KamiOrz/flightdesk/enclosure/soft-box-v6/README.md

# FlightDesk 方盒圆弧版 V6

以原横向方盒为基础，前壳 76×40 mm、厚 18.2 mm，平面转角 R7；正面外周增加 R1.8 连续过渡，背盖边缘 R1，底座上沿 R2.4。保持 65° 屏幕倾角，石墨灰主体与青绿色按键。预览为实际 CAD 几何的关屏示意，非实物照片。

后支撑新增两侧竖棱 R5、顶部后沿 R3、与底板交接 R2 的连续圆角。清除了 V5 底座上方残留的薄台阶。安装孔、倾斜配合面及配重槽保持原位置。只需重打 `weighted-base.stl` 即可替换 V5 底座。

## 文件

- `stl/`：毫米单位，已摆到 Z=0。前壳正面朝下、背盖外侧朝下；底座平放。圆弧正面接触面较小，可加 brim，避免过度象脚。
- `flightdesk-soft-box-v6.step`：8 个制造零件，不含电子板、屏幕及金属配重。
- `model.py`：CadQuery 建模源码，依赖项目原 V1 STEP 保留经过检查的板卡安装位置。
- `checks.json`、`mesh-checks.json`：实体及网格检查记录。

## 打印与装配

建议 0.4 mm 喷嘴、0.16–0.20 mm 层高、至少 3 圈墙。底座配重槽顶和定位柱需要支撑；依据切片检查启用局部支撑。壳体、按键小件也需检查切片悬空区域。先打印 `pin-fit-coupon.stl`，检查排针和打印公差，再打印整壳。

保留两排背向直排针：PCB 背面至针尖 8.25 mm，托架承托排针塑料座，不把金属针尖硬压在槽底。塑料座承托处使用约 0.3–0.5 mm 软垫微调，禁止挤压屏幕玻璃。板卡位置基于 LILYGO 官方 T-Display S3 STEP。

先从内部装入两个按键，再装止挡片（各一颗 M2×3 自攻螺钉）；放入主板，装背面托架并用四颗 M2×8 自攻螺钉固定。背盖从内侧用两颗 M3×8 螺钉固定底座，使用薄头，确认螺钉头不碰板件。

配重块 34×20×4.85 mm、中心孔 Ø6.2 mm，从底部放入 34.6×20.6 mm 槽。Ø5.8 mm 塑料柱定位；Ø12 mm 打印压片搭住配重，用一颗 M3×6 盘头自攻螺钉固定于塑料柱 Ø2.5 mm 导孔。螺钉头高不超过 2 mm，勿用尖端过长的替代件。金属 Ø6.2 mm 孔本身不参与攻丝。底部贴防滑胶条。

已通过零件互相干涉检查（含配重）、实体有效性检查及封闭 STL 网格检查。仓库实物照片展示了一次打印装配；螺钉、软垫与打印公差应以试装确认，不要强拧。
