KamiOrz/flightdesk/THIRD_PARTY.md

# Third-party notices

The MIT license applies to this project's original code, documentation and enclosure design. It does not relicense third-party components, aircraft liveries, trademarks or flight data.

- Arduino-ESP32 / ESP-IDF: licenses supplied by Espressif and their dependencies.
- TFT_eSPI: FreeBSD license, see its upstream distribution.
- ArduinoJson: MIT license.
- DejaVu Sans: bundled font and copyright notice at `assets/fonts/LICENSE_DEJAVU`; the generated clock glyphs are derived from this font. No Apple DIN Condensed font or its raster glyphs are included.
- Node dependencies: crypto-js, protobufjs and socket.io-client retain their upstream licenses. `npm ci` installs their license files.
- Aircraft type/operator labels are short factual identifiers. PlaneSlate content 1.0.32 supplied the original personal-build catalog, but no catalog bitmap images, generated RLE streams or AI edits derived from those images are distributed here. Optional import does not grant redistribution permission. See https://github.com/PlaneSlate/liveries and its notices before using assets.
- Product photographs show an assembled personal device with separately imported artwork. Their inclusion does not grant rights to third-party artwork, airline logos or paint designs visible on screen.
- Enclosure mounting dimensions were checked against LILYGO's T-Display-S3 mechanical reference. This repository distributes the designed case parts, not the vendor's board CAD files. Hardware documentation: https://github.com/Xinyuan-LilyGO/T-Display-S3.
- Flight positions and routes belong to their respective providers. The unofficial VariFlight adapter code is not an authorization to use, redistribute or commercially exploit provider data. Its web-client protocol constants are not user credentials; no private session tokens are bundled.
- Public airframe identity supplement: https://www.flightradar24.com/data/aircraft/B-4080 and https://api.adsbdb.com/v0/aircraft/B-4080. The internal CN_AF artwork key is not an asserted ICAO operator code.

External resources are subject to their respective terms and availability. No affiliation or endorsement is claimed.
