KamiOrz/flightdesk/enclosure/soft-box-v6/v6-preview.png

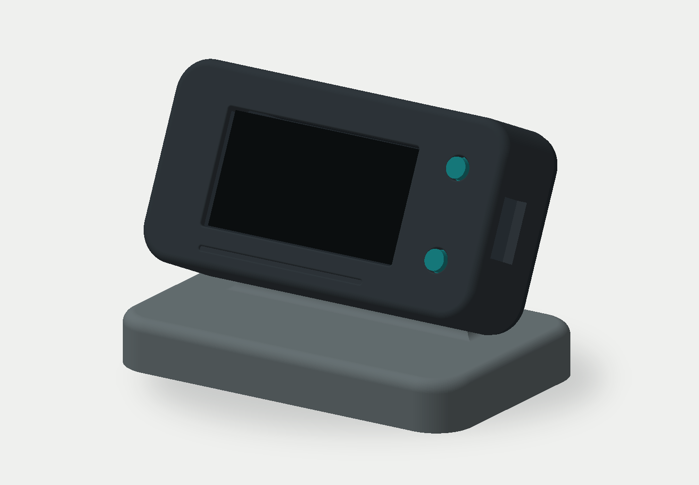
enclosure/soft-box-v6/v6-preview.png
