KamiOrz/flightdesk/enclosure/soft-box-v6/v6-rear.png

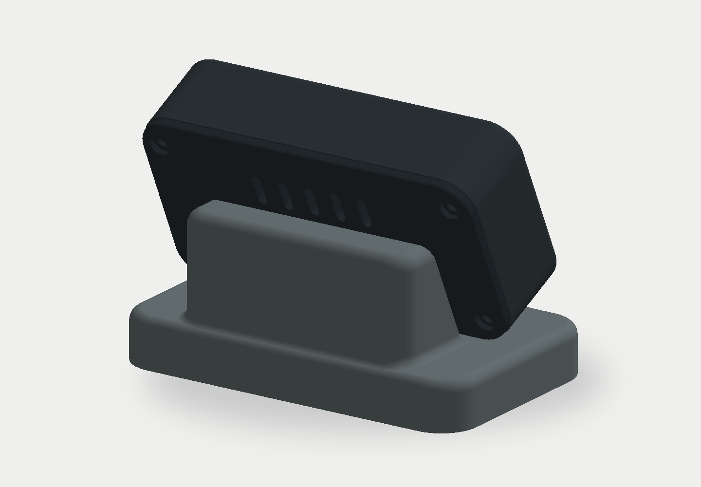
enclosure/soft-box-v6/v6-rear.png
