KamiOrz/flightdesk/enclosure/soft-box-v6/v6-side.png

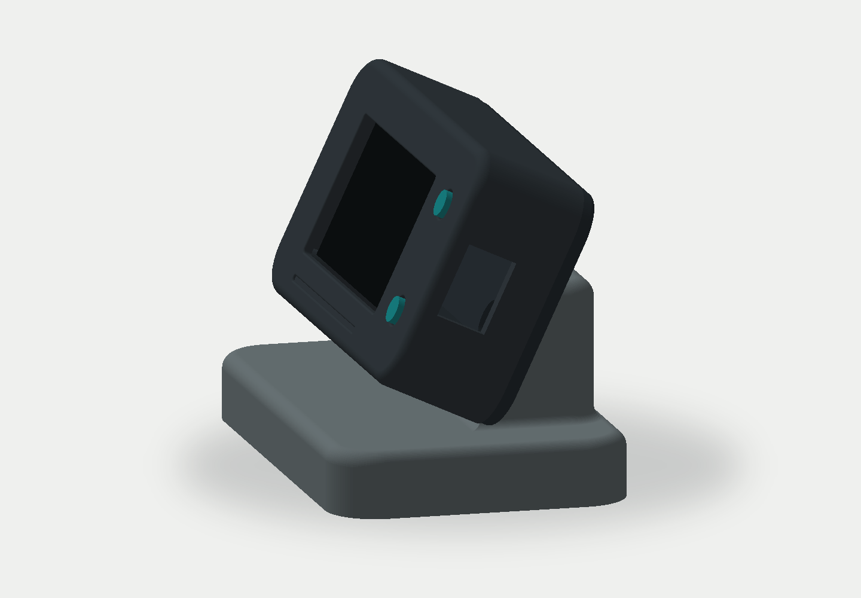
enclosure/soft-box-v6/v6-side.png
