KamiOrz/flightdesk/enclosure/flightdesk-assembly.step

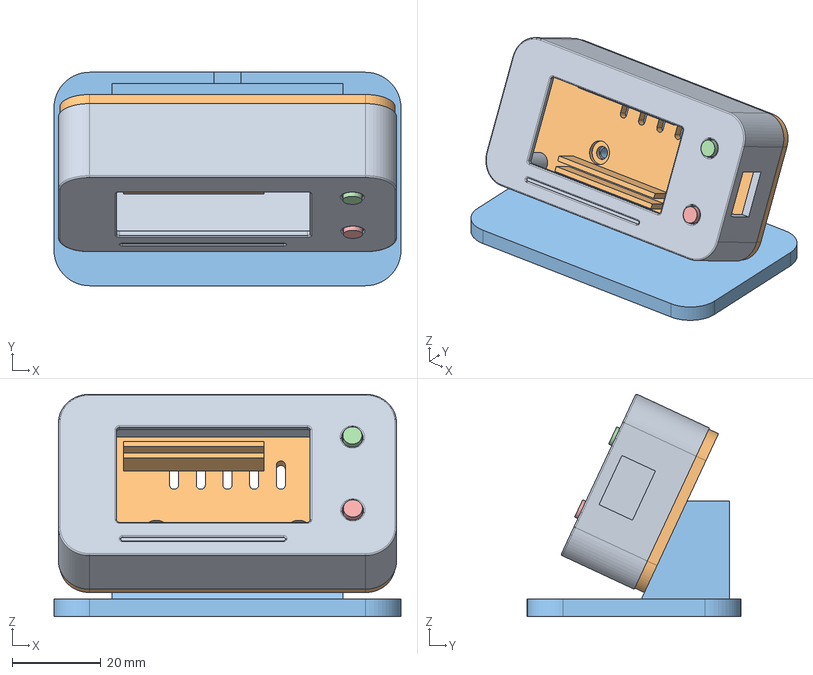
[picture p6: CAD file, 2026-11-07]
enclosure/flightdesk-assembly.step
78.0 x 48.0 x 50.0 mm
