KamiOrz/flightdesk/enclosure/soft-box-v6/flightdesk-soft-box-v6.step

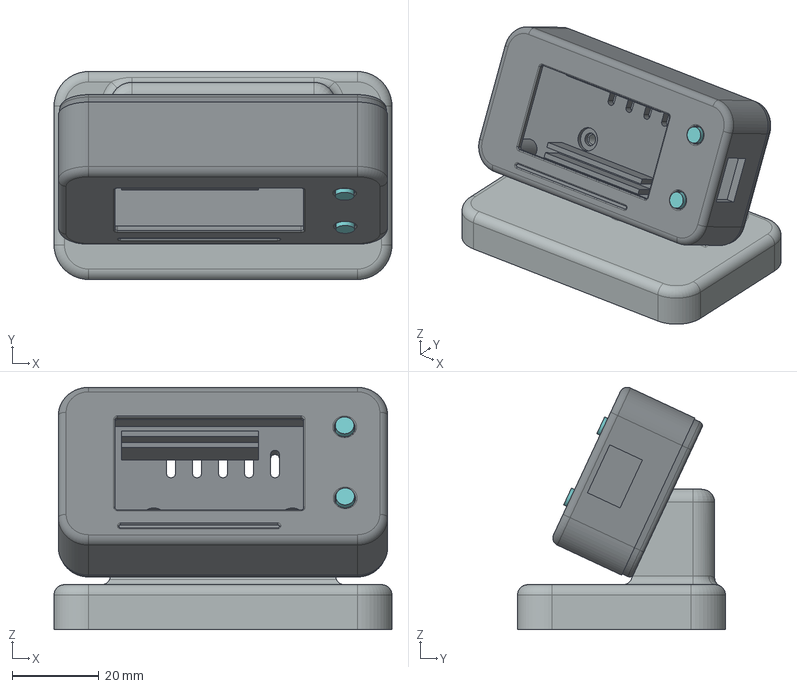
[picture p7: CAD file, 2026-11-07]
enclosure/soft-box-v6/flightdesk-soft-box-v6.step
78.0 x 48.0 x 55.9 mm
front-housing
rear-pin-carrier
weighted-base
weight-retainer
button-1
button-2
button-keeper-1
button-keeper-2
