KamiOrz/flightdesk/enclosure/soft-box-v6/stl/front-housing.stl

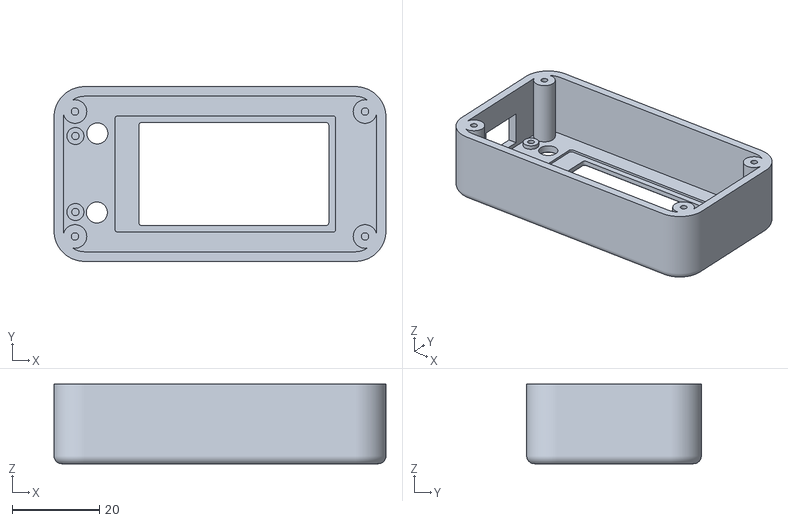
[picture p8: CAD file, 2026-11-07]
enclosure/soft-box-v6/stl/front-housing.stl
76.0 x 40.0 x 18.2
