KamiOrz/flightdesk/enclosure/soft-box-v6/stl/pin-fit-coupon.stl

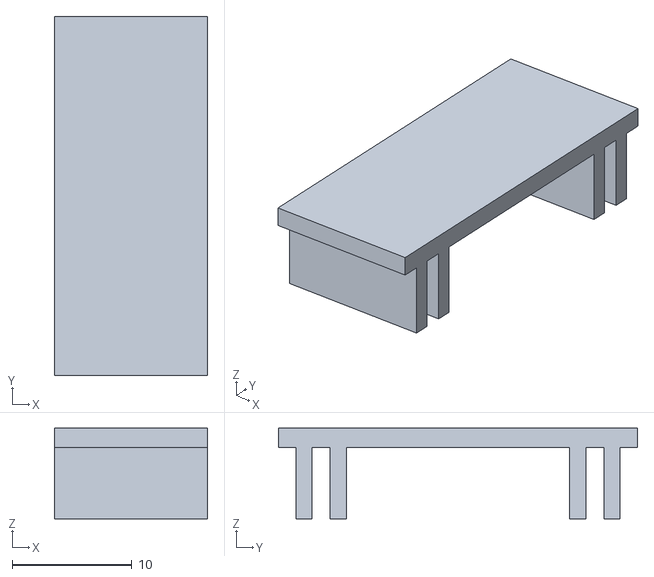
[picture p9: CAD file, 2026-11-07]
enclosure/soft-box-v6/stl/pin-fit-coupon.stl
12.8 x 30.0 x 7.58
