KamiOrz/flightdesk/enclosure/soft-box-v6/stl/button-keeper-1.stl

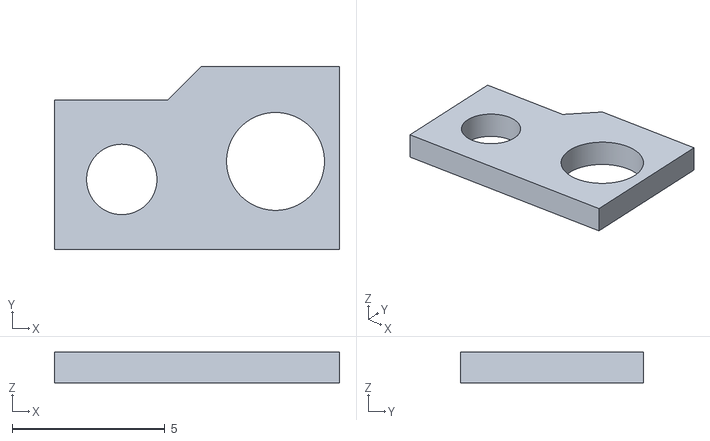
[picture p10: CAD file, 2026-11-07]
enclosure/soft-box-v6/stl/button-keeper-1.stl
9.32 x 6.00 x 1
