KamiOrz/flightdesk/enclosure/soft-box-v6/stl/rear-pin-carrier.stl

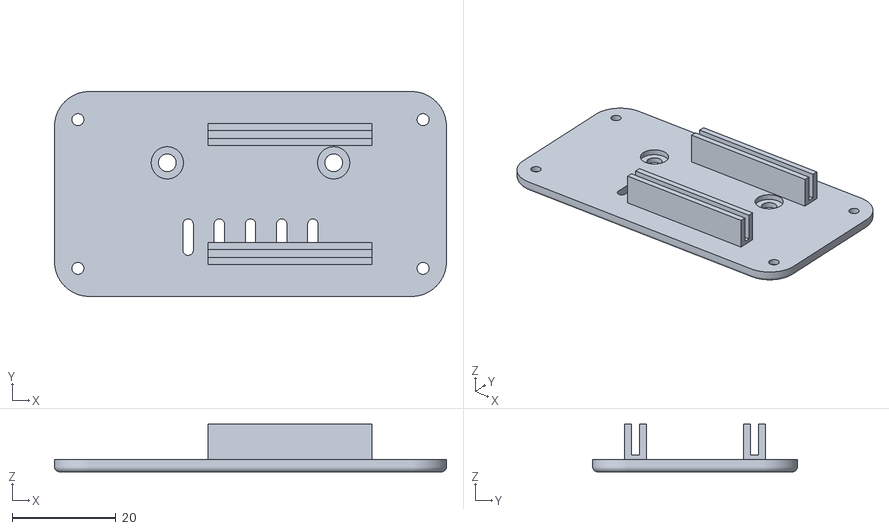
[picture p11: CAD file, 2026-11-07]
enclosure/soft-box-v6/stl/rear-pin-carrier.stl
75.4 x 39.4 x 9.18
