KamiOrz/flightdesk/enclosure/soft-box-v6/stl/weight-retainer.stl

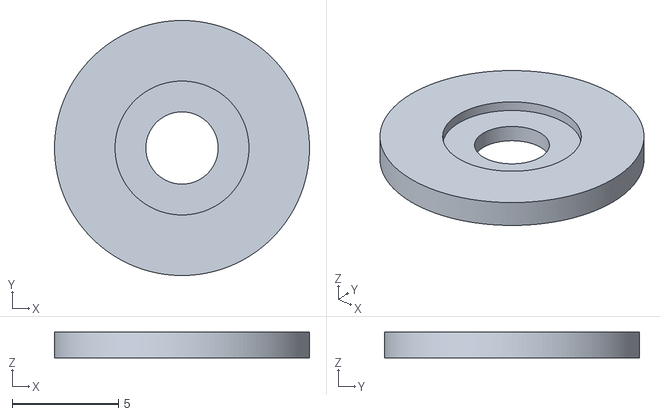
[picture p12: CAD file, 2026-11-07]
enclosure/soft-box-v6/stl/weight-retainer.stl
12.0 x 12.0 x 1.20
