KamiOrz/flightdesk/enclosure/soft-box-v6/stl/button-2.stl

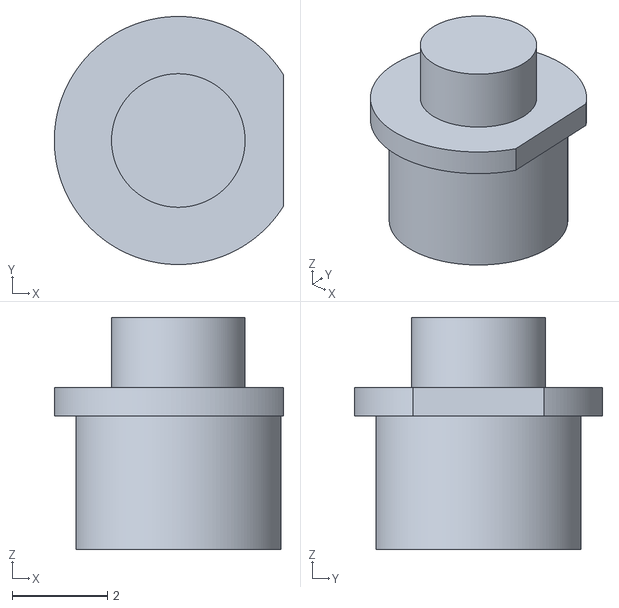
[picture p13: CAD file, 2026-11-07]
enclosure/soft-box-v6/stl/button-2.stl
4.81 x 5.20 x 4.87
