KamiOrz/flightdesk/enclosure/soft-box-v6/stl/weighted-base.stl

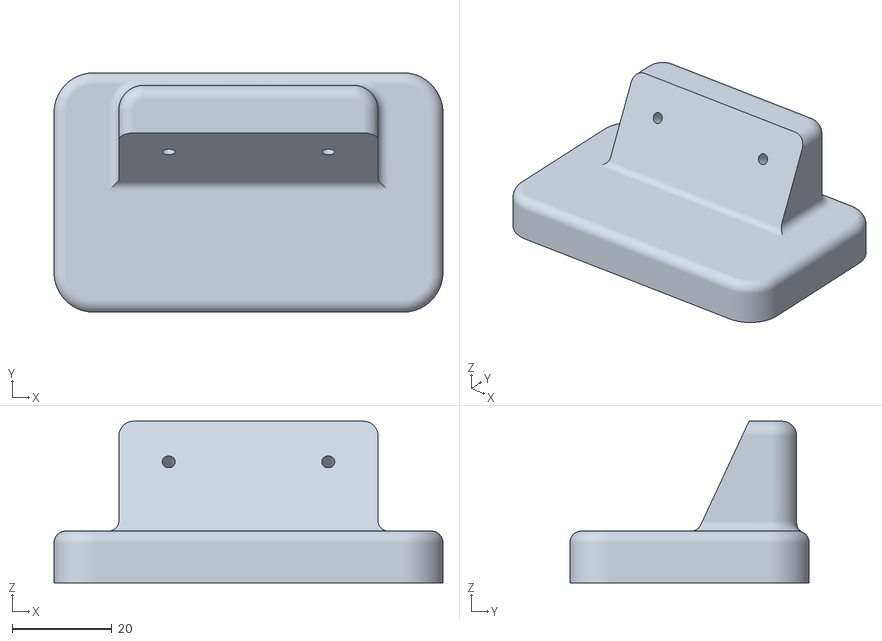
[picture p14: CAD file, 2026-11-07]
enclosure/soft-box-v6/stl/weighted-base.stl
78.0 x 48.0 x 32.4
