KamiOrz/flightdesk/(list of files, cad)

Other CAD files:
enclosure/soft-box-v6/stl/button-keeper-2.stl
enclosure/soft-box-v6/stl/button-1.stl
