KamiOrz/flightdesk/include/clock_font.h

#pragma once
#include <Arduino.h>
// DejaVu Sans digit rasterization; see assets/fonts/LICENSE_DEJAVU.
constexpr int CLOCK_GLYPH_W=38,CLOCK_GLYPH_H=78;
static const uint8_t CLOCK_GLYPH_0[] PROGMEM={0,0,0,0,0,0,0,21,173,238,217,64,0,0,0,0,0,0,0,0,0,0,0,0,0,4,223,255,255,255,251,48,0,0,0,0,0,0,0,0,0,0,0,0,127,255,255,255,255,255,245,0,0,0,0,0,0,0,0,0,0,0,7,255,255,255,255,255,255,255,80,0,0,0,0,0,0,0,0,0,0,95,255,255,255,255,255,255,255,226,0,0,0,0,0,0,0,0,0,1,223,255,255,255,255,255,255,255,251,16,0,0,0,0,0,0,0,0,9,255,255,255,255,255,255,255,255,255,96,0,0,0,0,0,0,0,0,46,255,255,255,234,136,191,255,255,255,209,0,0,0,0,0,0,0,0,159,255,255,252,80,0,21,223,255,255,246,0,0,0,0,0,0,0,2,239,255,255,194,0,0,0,78,255,255,252,16,0,0,0,0,0,0,6,255,255,255,64,0,0,0,6,255,255,255,64,0,0,0,0,0,0,11,255,255,249,0,0,0,0,0,191,255,255,128,0,0,0,0,0,0,46,255,255,243,0,0,0,0,0,95,255,255,209,0,0,0,0,0,0,111,255,255,176,0,0,0,0,0,12,255,255,243,0,0,0,0,0,0,159,255,255,96,0,0,0,0,0,8,255,255,247,0,0,0,0,0,0,223,255,254,32,0,0,0,0,0,4,255,255,250,0,0,0,0,0,2,239,255,252,0,0,0,0,0,0,1,223,255,253,0,0,0,0,0,5,255,255,249,0,0,0,0,0,0,0,175,255,255,48,0,0,0,0,8,255,255,246,0,0,0,0,0,0,0,143,255,255,80,0,0,0,0,10,255,255,243,0,0,0,0,0,0,0,95,255,255,128,0,0,0,0,12,255,255,225,0,0,0,0,0,0,0,63,255,255,160,0,0,0,0,30,255,255,192,0,0,0,0,0,0,0,30,255,255,192,0,0,0,0,63,255,255,160,0,0,0,0,0,0,0,12,255,255,225,0,0,0,0,79,255,255,144,0,0,0,0,0,0,0,11,255,255,242,0,0,0,0,111,255,255,112,0,0,0,0,0,0,0,9,255,255,243,0,0,0,0,127,255,255,96,0,0,0,0,0,0,0,8,255,255,245,0,0,0,0,159,255,255,80,0,0,0,0,0,0,0,7,255,255,246,0,0,0,0,175,255,255,64,0,0,0,0,0,0,0,6,255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
,176,0,0,0,0,0,0,0,0,0,0,0,0,0,0,0,46,255,255,176,0,0,0,0,0,0,0,0,0,0,0,0,0,0,0,46,255,255,176,0,0,0,0,0,0,0,0,0,0,0,0,0,0,0,46,255,255,176,0,0,0,0,0,0,0,0,0,0,0,0,0,0,0,46,255,255,176,0,0,0,0,0,0,0,0,0,0,0,0,0,0,0,46,255,255,176,0,0,0,0,0,0,0,0,0,0,0,0,0,0,0,30,255,255,176,0,0,0,0,0,0,0,0,0,0,9,238,238,238,238,239,255,255,254,238,238,238,238,80,0,0,0,0,0,10,255,255,255,255,255,255,255,255,255,255,255,255,96,0,0,0,0,0,9,255,255,255,255,255,255,255,255,255,255,255,255,96,0,0,0,0,0,9,255,255,255,255,255,255,255,255,255,255,255,255,96,0,0,0,0,0,9,255,255,255,255,255,255,255,255,255,255,255,255,96,0,0,0,0,0,9,255,255,255,255,255,255,255,255,255,255,255,255,96,0,0,0,0,0,9,255,255,255,255,255,255,255,255,255,255,255,255,96,0,0,0,0,0,9,255,255,255,255,255,255,255,255,255,255,255,255,96,0,0};
static const uint8_t CLOCK_GLYPH_2[] PROGMEM={0,0,0,0,0,0,56,189,255,219,114,0,0,0,0,0,0,0,0,0,0,0,0,1,109,255,255,255,255,255,162,0,0,0,0,0,0,0,0,0,0,1,126,255,255,255,255,255,255,255,96,0,0,0,0,0,0,0,0,1,93,255,255,255,255,255,255,255,255,248,0,0,0,0,0,0,0,0,26,255,255,255,255,255,255,255,255,255,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
static const uint8_t CLOCK_GLYPH_3[] PROGMEM={0,0,0,0,0,2,88,189,239,237,183,32,0,0,0,0,0,0,0,0,0,0,1,56,207,255,255,255,255,255,250,32,0,0,0,0,0,0,0,0,0,108,255,255,255,255,255,255,255,255,246,0,0,0,0,0,0,0,0,3,255,255,255,255,255,255,255,255,255,255,128,0,0,0,0,0,0,0,3,239,255,255,255,255,255,255,255,255,255,247,0,0,0,0,0,0,0,3,255,255,255,255,255,255,255,255,255,255,255,64,0,0,0,0,0,0,3,255,255,255,255,255,255,255,255,255,255,255,209,0,0,0,0,0,0,3,255,255,255,253,169,136,155,239,255,255,255,247,0,0,0,0,0,0,3,255,255,200,83,16,0,1,73,255,255,255,254,16,0,0,0,0,0,3,255,182,48,0,0,0,0,0,111,255,255,255,96,0,0,0,0,0,4,197,32,0,0,0,0,0,0,7,255,255,255,176,0,0,0,0,0,1,32,0,0,0,0,0,0,0,0,191,255,255,226,0,0,0,0,0,0,0,0,0,0,0,0,0,0,0,79,255,255,245,0,0,0,0,0,0,0,0,0,0,0,0,0,0,0,12,255,255,248,0,0,0,0,0,0,0,0,0,0,0,0,0,0,0,7,255,255,250,0,0,0,0,0,0,0,0,0,0,0,0,0,0,0,4,255,255,252,0,0,0,0,0,0,0,0,0,0,0,0,0,0,0,2,239,255,253,0,0,0,0,0,0,0,0,0,0,0,0,0,0,0,1,223,255,254,16,0,0,0,0,0,0,0,0,0,0,0,0,0,0,0,207,255,254,16,0,0,0,0,0,0,0,0,0,0,0,0,0,0,0,191,255,254,32,0,0,0,0,0,0,0,0,0,0,0,0,0,0,0,191,255,254,16,0,0,0,0,0,0,0,0,0,0,0,0,0,0,0,191,255,254,16,0,0,0,0,0,0,0,0,0,0,0,0,0,0,0,207,255,254,0,0,0,0,0,0,0,0,0,0,0,0,0,0,0,1,223,255,252,0,0,0,0,0,0,0,0,0,0,0,0,0,0,0,2,255,255,250,0,0,0,0,0,0,0,0,0,0,0,0,0,0,0,5,255,255,248,0,0,0,0,0,0,0,0,0,0,0,0,0,0,0,9,255,255,245,0,0,0,0,0,0,0,0,0,0,0,0,0,0,0,29,255,255,226,0,0,0,0,0,0,0,0,0,0,0,0,0,0,0,111,255,255,160,0,0,0,0,0,0,0,0,0,0,0,0,0,0,1,223,255,255,80,0,0,0,0,0,0,0,0,0,0,0,0,0,0,27,255,255,252,0,0,0,0,0,0,0,0,0,0,0,0,0,0,3,207,255,255,245,0,0,0,0,0,0,0,0,0,0,17,17,18,53,175,255,255,255,160,0,0,0,0,0,0,0,0,0,1,239,255,255,255,255,255,255,252,16,0,0,0,0,0,0,0,0,0,1,223,255,255,255,255,255,255,194,0,0,0,0,0,0,0,0,0,0,1,239,255,255,255,255,255,216,16,0,0,0,0,0,0,0,0,0,0,1,239,255,255,255,255,255,161,0,0,0,0,0,0,0,0,0,0,0,1,239,255,255,255,255,255,253,96,0,0,0,0,0,0,0,0,0,0,1,223,239,255,255,255,255,255,248,0,0,0,0,0,0,0,0,0,0,1,255,255,255,255,255,255,255,255,128,0,0,0,0,0,0,0,0,0,0,86,102,102,121,223,255,255,255,245,0,0,0,0,0,0,0,0,0,0,0,0,0,1,55,239,255,255,254,32,0,0,0,0,0,0,0,0,0,0,0,0,0,0,61,255,255,255,128,0,0,0,0,0,0,0,0,0,0,0,0,0,0,3,239,255,255,226,0,0,0,0,0,0,0,0,0,0,0,0,0,0,0,95,255,255,246,0,0,0,0,0,0,0,0,0,0,0,0,0,0,0,11,255,255,251,0,0,0,0,0,0,0,0,0,0,0,0,0,0,0,4,255,255,254,32,0,0,0,0,0,0,0,0,0,0,0,0,0,0,1,207,255,255,80,0,0,0,0,0,0,0,0,0,0,0,0,0,0,0,159,255,255,128,0,0,0,0,0,0,0,0,0,0,0,0,0,0,0,95,255,255,160,0,0,0,0,0,0,0,0,0,0,0,0,0,0,0,47,255,255,192,0,0,0,0,0,0,0,0,0,0,0,0,0,0,0,30,255,255,209,0,0,0,0,0,0,0,0,0,0,0,0,0,0,0,12,255,255,225,0,0,0,0,0,0,0,0,0,0,0,0,0,0,0,12,255,255,241,0,0,0,0,0,0,0,0,0,0,0,0,0,0,0,11,255,255,242,0,0,0,0,0,0,0,0,0,0,0,0,0,0,0,11,255,255,241,0,0,0,0,0,0,0,0,0,0,0,0,0,0,0,11,255,255,241,0,0,0,0,0,0,0,0,0,0,0,0,0,0,0,12,255,255,225,0,0,0,0,0,0,0,0,0,0,0,0,0,0,0,29,255,255,209,0,0,0,0,0,0,0,0,0,0,0,0,0,0,0,30,255,255,192,0,0,0,0,0,0,0,0,0,0,0,0,0,0,0,79,255,255,176,0,0,0,0,0,0,0,0,0,0,0,0,0,0,0,127,255,255,144,0,0,0,0,0,0,0,0,0,0,0,0,0,0,0,175,255,255,112,0,0,0,0,0,0,0,0,0,0,0,0,0,0,2,239,255,255,64,0,0,0,0,16,0,0,0,0,0,0,0,0,0,7,255,255,254,16,0,0,0,0,100,0,0,0,0,0,0,0,0,0,29,255,255,251,0,0,0,0,0,142,64,0,0,0,0,0,0,0,0,159,255,255,246,0,0,0,0,0,127,230,16,0,0,0,0,0,0,7,255,255,255,226,0,0,0,0,0,127,255,148,0,0,0,0,0,2,143,255,255,255,144,0,0,0,0,0,127,255,254,149,32,0,0,19,107,255,255,255,254,48,0,0,0,0,0,127,255,255,255,202,152,137,172,255,255,255,255,249,0,0,0,0,0,0,127,255,255,255,255,255,255,255,255,255,255,255,209,0,0,0,0,0,0,127,255,255,255,255,255,255,255,255,255,255,255,64,0,0,0,0,0,0,143,255,255,255,255,255,255,255,255,255,255,246,0,0,0,0,0,0,0,42,255,255,255,255,255,255,255,255,255,255,80,0,0,0,0,0,0,0,1,76,255,255,255,255,255,255,255,255,195,0,0,0,0,0,0,0,0,0,1,58,255,255,255,255,255,255,197,16,0,0,0,0,0,0,0,0,0,0,0,20,140,222,254,218,115,0,0,0,0,0,0,0,0};
static const uint8_t CLOCK_GLYPH_4[] PROGMEM={0,0,0,0,0,0,0,0,0,0,79,255,255,255,80,0,0,0,0,0,0,0,0,0,0,0,0,0,0,159,255,255,255,80,0,0,0,0,0,0,0,0,0,0,0,0,0,1,223,255,255,255,80,0,0,0,0,0,0,0,0,0,0,0,0,0,5,255,255,255,255,80,0,0,0,0,0,0,0,0,0,0,0,0,0,11,255,255,255,255,80,0,0,0,0,0,0,0,0,0,0,0,0,0,46,255,255,255,255,80,0,0,0,0,0,0,0,0,0,0,0,0,0,127,255,255,255,255,80,0,0,0,0,0,0,0,0,0,0,0,0,0,207,255,255,255,255,80,0,0,0,0,0,0,0,0,0,0,0,0,3,255,255,255,255,255,80,0,0,0,0,0,0,0,0,0,0,0,0,8,255,255,239,255,255,80,0,0,0,0,0,0,0,0,0,0,0,0,13,255,253,159,255,255,80,0,0,0,0,0,0,0,0,0,0,0,0,95,255,249,127,255,255,80,0,0,0,0,0,0,0,0,0,0,0,0,159,255,245,127,255,255,80,0,0,0,0,0,0,0,0,0,0,0,1,239,255,225,127,255,255,80,0,0,0,0,0,0,0,0,0,0,0,6,255,255,160,143,255,255,80,0,0,0,0,0,0,0,0,0,0,0,11,255,255,80,143,255,255,80,0,0,0,0,0,0,0,0,0,0,0,46,255,253,16,143,255,255,80,0,0,0,0,0,0,0,0,0,0,0,127,255,249,0,143,255,255,80,0,0,0,0,0,0,0,0,0,0,0,207,255,244,0,143,255,255,80,0,0,0,0,0,0,0,0,0,0,4,255,255,193,0,143,255,255,80,0,0,0,0,0,0,0,0,0,0,9,255,255,128,0,143,255,255,80,0,0,0,0,0,0,0,0,0,0,29,255,255,48,0,143,255,255,80,0,0,0,0,0,0,0,0,0,0,95,255,252,16,0,143,255,255,80,0,0,0,0,0,0,0,0,0,0,175,255,247,0,0,143,255,255,80,0,0,0,0,0,0,0,0,0,2,239,255,242,0,0,143,255,255,80,0,0,0,0,0,0,0,0,0,6,255,255,176,0,0,143,255,255,80,0,0,0,0,0,0,0,0,0,11,255,255,96,0,0,143,255,255,80,0,0,0,0,0,0,0,0,0,63,255,254,32,0,0,143,255,255,80,0,0,0,0,0,0,0,0,0,143,255,250,0,0,0,143,255,255,80,0,0,0,0,0,0,0,0,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
,0,0,0,0,0,0,0,0,0,0,0,0,0,0,3,255,255,254,16,0,0,0,0,0,0,0,0,0,0,0,0,0,0,7,255,255,252,0,0,0,0,0,0,0,0,0,0,0,0,0,0,0,12,255,255,249,0,0,0,0,0,0,0,0,0,0,0,0,0,0,0,79,255,255,246,0,0,0,0,0,32,0,0,0,0,0,0,0,0,0,175,255,255,243,0,0,0,0,0,121,0,0,0,0,0,0,0,0,4,255,255,255,192,0,0,0,0,0,127,128,0,0,0,0,0,0,0,29,255,255,255,128,0,0,0,0,0,111,250,48,0,0,0,0,0,1,191,255,255,254,48,0,0,0,0,0,111,255,215,16,0,0,0,0,59,255,255,255,250,0,0,0,0,0,0,111,255,255,200,65,0,0,56,223,255,255,255,244,0,0,0,0,0,0,111,255,255,255,220,187,188,223,255,255,255,255,160,0,0,0,0,0,0,111,255,255,255,255,255,255,255,255,255,255,254,32,0,0,0,0,0,0,111,255,255,255,255,255,255,255,255,255,255,245,0,0,0,0,0,0,0,111,255,255,255,255,255,255,255,255,255,255,112,0,0,0,0,0,0,0,127,255,255,255,255,255,255,255,255,255,247,0,0,0,0,0,0,0,0,23,223,255,255,255,255,255,255,255,254,80,0,0,0,0,0,0,0,0,0,21,174,255,255,255,255,255,254,129,0,0,0,0,0,0,0,0,0,0,0,1,71,173,239,254,201,81,0,0,0,0,0,0,0,0};
static const uint8_t CLOCK_GLYPH_6[] PROGMEM={0,0,0,0,0,0,0,0,1,106,222,253,200,65,0,0,0,0,0,0,0,0,0,0,0,0,1,126,255,255,255,255,254,130,0,0,0,0,0,0,0,0,0,0,0,60,255,255,255,255,255,255,255,129,0,0,0,0,0,0,0,0,0,3,239,255,255,255,255,255,255,255,245,0,0,0,0,0,0,0,0,0,62,255,255,255,255,255,255,255,255,244,0,0,0,0,0,0,0,0,1,207,255,255,255,255,255,255,255,255,245,0,0,0,0,0,0,0,0,10,255,255,255,255,255,255,255,255,255,245,0,0,0,0,0,0,0,0,95,255,255,255,252,168,137,190,255,255,245,0,0,0,0,0,0,0,1,223,255,255,253,99,0,0,20,142,255,245,0,0,0,0,0,0,0,6,255,255,255,179,0,0,0,0,4,175,244,0,0,0,0,0,0,0,29,255,255,251,16,0,0,0,0,0,24,245,0,0,0,0,0,0,0,95,255,255,210,0,0,0,0,0,0,0,117,0,0,0,0,0,0,0,191,255,255,96,0,0,0,0,0,0,0,1,0,0,0,0,0,0,3,255,255,252,0,0,0,0,0,0,0,0,0,0,0,0,0,0,0,7,255,255,245,0,0,0,0,0,0,0,0,0,0,0,0,0,0,0,12,255,255,209,0,0,0,0,0,0,0,0,0,0,0,0,0,0,0,63,255,255,128,0,0,0,0,0,0,0,0,0,0,0,0,0,0,0,111,255,255,64,0,0,0,0,0,0,0,0,0,0,0,0,0,0,0,175,255,253,16,0,0,0,0,0,0,0,0,0,0,0,0,0,0,0,223,255,250,0,0,0,0,0,0,0,0,0,0,0,0,0,0,0,3,255,255,247,0,0,0,0,0,0,0,0,0,0,0,0,0,0,0,5,255,255,244,0,0,0,0,0,0,0,0,0,0,0,0,0,0,0,8,255,255,226,0,0,0,0,0,0,0,0,0,0,0,0,0,0,0,10,255,255,208,0,0,0,0,0,0,0,0,0,0,0,0,0,0,0,12,255,255,176,0,0,0,0,0,0,0,0,0,0,0,0,0,0,0,30,255,255,144,0,0,5,137,152,98,0,0,0,0,0,0,0,0,0,47,255,255,128,0,5,206,255,255,237,162,0,0,0,0,0,0,0,0,79,255,255,96,0,142,255,255,255,255,253,96,0,0,0,0,0,0,0,95,255,255,80,9,255,255,255,255,255,255,231,0,0,0,0,0,0,0,127,255,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
0,0,0,0,0,0,0,0,0,0,0,0,0,0,207,255,255,80,0,0,0,0,0,0,0,0,0,0,0,0,0,0,2,239,255,254,48,0,0,0,0,0,0,0,0,0,0,0,0,0,0,4,255,255,253,0,0,0,0,0,0,0,0,0,0,0,0,0,0,0,7,255,255,250,0,0,0,0,0,0,0,0,0,0,0,0,0,0,0,10,255,255,247,0,0,0,0,0,0,0,0,0,0,0,0,0,0,0,13,255,255,244,0,0,0,0,0,0,0,0,0,0,0,0,0,0,0,46,255,255,226,0,0,0,0,0,0,0,0,0,0,0,0,0,0,0,95,255,255,192,0,0,0,0,0,0,0,0,0,0,0,0,0,0,0,143,255,255,144,0,0,0,0,0,0,0,0,0,0,0,0,0,0,0,191,255,255,96,0,0,0,0,0,0,0,0,0,0,0,0,0,0,1,223,255,255,48,0,0,0,0,0,0,0,0,0,0,0,0,0,0,3,255,255,253,16,0,0,0,0,0,0,0,0,0,0,0,0,0,0,6,255,255,251,0,0,0,0,0,0,0,0,0,0,0,0,0,0,0,9,255,255,248,0,0,0,0,0,0,0,0,0,0,0,0,0,0,0,11,255,255,245,0,0,0,0,0,0,0,0,0,0,0,0,0,0,0,30,255,255,242,0,0,0,0,0,0,0,0,0,0};
static const uint8_t CLOCK_GLYPH_8[] PROGMEM={0,0,0,0,0,0,0,73,206,255,219,131,0,0,0,0,0,0,0,0,0,0,0,0,0,76,255,255,255,255,255,179,0,0,0,0,0,0,0,0,0,0,0,25,255,255,255,255,255,255,255,112,0,0,0,0,0,0,0,0,0,1,175,255,255,255,255,255,255,255,248,0,0,0,0,0,0,0,0,0,10,255,255,255,255,255,255,255,255,255,112,0,0,0,0,0,0,0,0,111,255,255,255,255,255,255,255,255,255,244,0,0,0,0,0,0,0,2,239,255,255,255,255,255,255,255,255,255,252,16,0,0,0,0,0,0,9,255,255,255,255,201,136,173,255,255,255,255,96,0,0,0,0,0,0,46,255,255,255,230,32,0,3,143,255,255,255,193,0,0,0,0,0,0,127,255,255,254,64,0,0,0,6,255,255,255,244,0,0,0,0,0,0,191,255,255,245,0,0,0,0,0,127,255,255,248,0,0,0,0,0,2,239,255,255,160,0,0,0,0,0,12,255,255,252,0,0,0,0,0,5,255,255,255,48,0,0,0,0,0,6,255,255,254,32,0,0,0,0,7,255,255,252,0,0,0,0,0,0,1,239,255,255,80,0,0,0,0,9,255,255,248,0,0,0,0,0,0,0,175,255,255,112,0,0,0,0,11,255,255,245,0,0,0,0,0,0,0,127,255,255,128,0,0,0,0,12,255,255,243,0,0,0,0,0,0,0,95,255,255,144,0,0,0,0,29,255,255,225,0,0,0,0,0,0,0,63,255,255,160,0,0,0,0,29,255,255,225,0,0,0,0,0,0,0,47,255,255,176,0,0,0,0,29,255,255,209,0,0,0,0,0,0,0,47,255,255,176,0,0,0,0,29,255,255,208,0,0,0,0,0,0,0,47,255,255,160,0,0,0,0,12,255,255,225,0,0,0,0,0,0,0,47,255,255,160,0,0,0,0,11,255,255,225,0,0,0,0,0,0,0,63,255,255,144,0,0,0,0,10,255,255,242,0,0,0,0,0,0,0,79,255,255,112,0,0,0,0,8,255,255,244,0,0,0,0,0,0,0,127,255,255,96,0,0,0,0,6,255,255,247,0,0,0,0,0,0,0,159,255,255,48,0,0,0,0,3,255,255,250,0,0,0,0,0,0,1,207,255,253,16,0,0,0,0,0,2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
,0,0,0,0,0,0,0,0,0,0,0,0,0,0,0,0,0,0,0,0,0,0,0,0,0,0,0,0,0,0,0,0,0,0,0,0,0,0,0,0,0,0,0,0,0};
static const uint8_t* const CLOCK_GLYPHS[]={CLOCK_GLYPH_0,CLOCK_GLYPH_1,CLOCK_GLYPH_2,CLOCK_GLYPH_3,CLOCK_GLYPH_4,CLOCK_GLYPH_5,CLOCK_GLYPH_6,CLOCK_GLYPH_7,CLOCK_GLYPH_8,CLOCK_GLYPH_9,CLOCK_GLYPH_10};
