KamiOrz/flightdesk/include/trust_roots.h

#pragma once
// Mozilla roots from system CA store; HTTPS remains certificate-verified.
static const char TRUST_ROOTS[] PROGMEM = R"CERT(
-----BEGIN CERTIFICATE-----
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
bP6MvPJwNQzcmRk13NfIRmPVNnGuV/u3gm3c
-----END CERTIFICATE-----
-----BEGIN CERTIFICATE-----
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
-----END CERTIFICATE-----
-----BEGIN CERTIFICATE-----
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
MrY=
-----END CERTIFICATE-----
-----BEGIN CERTIFICATE-----
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
-----END CERTIFICATE-----
)CERT";
