KamiOrz/flightdesk/include/artwork.h

#pragma once
#include <Arduino.h>
#include <array>
// No third-party bitmap artwork is distributed in this source package.
constexpr int ART_W=248,ART_H=64;
struct LiveryArt {const char*airline;const char*type;const uint16_t*data;};
static const std::array<LiveryArt,0> LIVERIES{};
struct TypeLabel {const char*code;const char*name;};
static const TypeLabel TYPE_LABELS[]={
 {"A109","Agusta A109"},
 {"A124","An-124"},
 {"A139","AW139"},
 {"A140","An-140"},
 {"A148","An-148"},
 {"A158","An-158"},
 {"A169","Leonardo AW169"},
 {"A19N","A319neo"},
 {"A20N","A320neo"},
 {"A21N","A321neo"},
 {"A306","A300-600F"},
 {"A30B","A300"},
 {"A318","A318"},
 {"A319","A319"},
 {"A320","A320ceo"},
 {"A321","A321ceo"},
 {"A332","A330-200"},
 {"A333","A330-300"},
 {"A338","A330-800"},
 {"A339","A330-900"},
 {"A342","A340-200"},
 {"A343","A340-300"},
 {"A345","A340-500"},
 {"A346","A340-600"},
 {"A359","A350-900"},
 {"A35K","A350-1000"},
 {"A388","A380-800"},
 {"A400","A400M"},
 {"AA5","Grumman AA-5"},
 {"AN12","An-12"},
 {"AN24","An-24"},
 {"AN26","An-26"},
 {"AN28","An-28"},
 {"AS50","Airbus Helicopters AS350"},
 {"AT43","ATR 42-300"},
 {"AT45","ATR 42-500"},
 {"AT46","ATR 42-600"},
 {"AT76","ATR 72-214A"},
 {"B190","1900"},
 {"B38M","B737 MAX 8"},
 {"B39M","B737 MAX 9"},
 {"B3XM","B737 MAX 10"},
 {"B407","Bell 407"},
 {"B462","Bae 146-200"},
 {"B712","B717"},
 {"B734","B737-400"},
 {"B736","B737-600"},
 {"B737","B737-700"},
 {"B738","B737-800"},
 {"B739","B737-900"},
 {"B742","B747-200M"},
 {"B744","B747-400M"},
 {"B748","B747-8I"},
 {"B752","Boeing 757-200"},
 {"B753","B757-300"},
 {"B763","B767-300F"},
 {"B764","B767-400ER"},
 {"B772","B777-200"},
 {"B773","B777-300"},
 {"B77L","B777-200LR"},
 {"B77W","B777-300ER"},
 {"B788","B787-8"},
 {"B789","B787-9"},
 {"B78X","B787-10"},
 {"BALL","Hot Air Balloon"},
 {"BCS1","A220-100"},
 {"BCS3","A220-300"},
 {"C152","Cessna 152"},
 {"C162","C162"},
 {"C172","Cessna 172 Skyhawk"},
 {"C182","Cessna 182 Skylane"},
 {"C185","Cessna 185"},
 {"C206","Cessna 206 Stationair"},
 {"C208","Cessna 208"},
 {"C27J","Alenia C-27J Spartan"},
 {"C919","Comac C919"},
 {"CL35","BD-100 Challenger 350"},
 {"CL60","Canadair Challenger 600"},
 {"CRJ2","Regional Jet 200"},
 {"CRJ7","CRJ700"},
 {"CRJ9","Regional Jet 900"},
 {"DH3T","de Havilland DHC-3 Turbo Otter"},
 {"E170","E170"},
 {"E190","E190"},
 {"E195","E195"},
 {"E295","E195-E2"},
 {"E45X","Embraer ERJ-145XR"},
 {"E75L","E175"},
 {"E75S","E175"},
 {"EC35","Airbus Helicopters EC135"},
 {"EC45","Airbus H145"},
 {"H500","MD 500"},
 {"IR23","IAR-823"},
 {"K100","Kodiak 100"},
 {"N262","Aerosp. 262"},
 {"NOMA","GAF Nomad"},
 {"P28R","PA-28R"},
 {"PC12","PC-12"},
 {"RJ85","Avro RJ85"},
 {"SHIP","Zeppelin NT"},
 {"WW24","1124 Westwind"},
};
struct AirlineLabel {const char*code;const char*name;const char*iata;};
static const AirlineLabel AIRLINE_LABELS[]={
 {"AAL","American Airlines","AA"},
 {"AFR","Air France","AF"},
 {"ANA","All Nippon Airways","NH"},
 {"BAW","British Airways","BA"},
 {"CAL","China Airlines","CI"},
 {"CBG","Guangxi Beibu Guld Airlines",""},
 {"CBJ","Beijing Capital Airlines","JD"},
 {"CCA","Air China","CA"},
 {"CDC","Loong Air","GJ"},
 {"CDG","Shandong Airlines","SC"},
 {"CES","China Eastern Airlines","MU"},
 {"CHB","West Air",""},
 {"CHH","Hainan Airlines","HU"},
 {"CPA","Cathay Pacific","CX"},
 {"CQH","Spring Airlines","9C"},
 {"CQN","Chongqing Airlines","OQ"},
 {"CSC","Sichuan Airlines","3U"},
 {"CSH","Shanghai Airlines","FM"},
 {"CSN","China Southern Airlines","CZ"},
 {"CSZ","Shenzhen Airlines","ZH"},
 {"CUA","China United Airlines","KN"},
 {"CXA","XiamenAir","MF"},
 {"DAL","Delta Air Lines","DL"},
 {"DKH","Juneyao Air",""},
 {"DLH","Lufthansa","LH"},
 {"EVA","EVA Air","BR"},
 {"GCR","Tianjin Airlines","GS"},
 {"HXA","China Express Airlines","A6"},
 {"JAL","Japan Airlines","JL"},
 {"JYH","9 Air","AQ"},
 {"KAL","Korean Air","KE"},
 {"KLM","KLM","KL"},
 {"LKE","Lucky Air","8L"},
 {"OKA","Okay Airways",""},
 {"QTR","Qatar Airways","QR"},
 {"RUI","RUI",""},
 {"SIA","Singapore Airlines","SQ"},
 {"SNG","Longjiang Airlines","V7"},
 {"SWR","SWISS","LX"},
 {"THA","Thai Airways International","TG"},
 {"THY","Turkish Airlines","TK"},
 {"UAE","Emirates","EK"},
 {"UAL","United Airlines","UA"},
};
